Max-Sum/HP-fan-proxy/(threads)

Thread 2 (2020-05-05):

I can't find the connectors :(

Dredok, 2020-05-05:
I have looked at Ebay, aliexpress and amazon and didnt find the proper connectors ... do you have some reference? I tried to look for what you said but got nowhere :(

Dredok, 2020-05-05:
okey I think these should work:
https://es.rs-online.com/web/p/conectores-macho-para-pcb/1361015/

Closed 2020-05-17.

Thread 3 (2020-07-03):

Where do you take power from?

stemsin, 2020-07-03:
Hi,

Doing a similar thing on my dl380e gen8, but without Arduino and PWM. Just bought silent fans. They work fine if I take power from PCI socket and shortcut pins 4-6 on the fan socket. But I didn't manage to power them from the fan socket itself (pin 1 and 4/5/6 short).
Any suggestions?

641i130, 2021-11-19:
Hey, I'm about to do this with my dl380e gen8 as well! I'm interested in your results if any!

Thread 4 (2020-07-18):

the "2x3 PH2.0" Connector is nowhere to be found

catSIXe, 2020-07-18:
the "2x3 PH2.0" Connector is nowhere to be found, checked eBay... Google doesnt know it too. only 2 pin PH2.0 Connectors

niraami, 2020-08-24:
For future reference the connector name is actually PHD2.0, PH is single row (I found this out in a super random [PDF](https://jst.de/uploads/product_overview/JST%20Product%20Overview_JD09.pdf) after hours of searching, that was fun)
This is [one of the listings](https://www.aliexpress.com/item/4000938719673.html) that I found for it. Haven't received it yet, but 2x3P should be correct. Will post a picture when I do... if I don't forget.

niraami, 2020-09-24:
Promised a follow up, so here it is ;)

The connector totally works! I currently can't test it electrically, but the fit seems quite good.
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

The only small thing that requires modification is the guides on the side, but that was only about 30 seconds with a sharp blade (it's reaaally soft plastic).
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

Happy tinkering!

Thread 5 (2020-10-22):

No Low Pass Filters

brinary01, 2020-10-22:
Hello,

Thank you for the write up. In your description, you say that you connected A to PWM directly read many times and. Took the average, what exactly do you mean? Did you connect the fans and run the server for a while monitoring the Arduino? Thank you
