Max-Sum/HP-fan-proxy/(commit log)

2018-06-08 Compute the fan speed using matrix
    Balance fan speed when iLO decided to ramp up too much on PCIe area.
    [hp_fan.ino]
2019-02-04 Use Digital Read and Increase PWM frequency
    - 3.3V is enough for digital pins to read.
    - 25kHz is the recomment frequency for PWM Fans. But arduino can only output a few set of frequencies, so 31.25kHz is used.
